OddballNo3/1u-VGA-driver/vga driver BOM.ods

Source:
Date:
Tool:
Generator:
Component Count: | 61
Collated Components:
Item | Qty | Reference(s) | Value | Footprint | PN
1 | 7 | C1, C4, C5, C8, C10, C12, C13 | 100n | Jfootprints:C_0805_2012Metric_Pad1.18x1.45mm_HandSolder
2 | 8 | C2, C3, C6, C7, C9, C11, C14, C15 | 10uF | Jfootprints:C_0805_2012Metric_Pad1.18x1.45mm_HandSolder
3 | 1 | D10 | BLUELED | Jfootprints:LED_D3.0mm
4 | 1 | D11 | GREENLED | Jfootprints:LED_D3.0mm
5 | 1 | D12 | REDLED | Jfootprints:LED_D3.0mm
6 | 1 | J1 | Conn_01x10 | Connector_IDC:IDC-Header_2x05_P2.54mm_Vertical
7 | 1 | J2 | RED OUT | Jfootprints:thonk switched jack | https://www.taydaelectronics.com/pj-3001f-3-5-mm-mono-phone-jack.html
8 | 1 | J3 | GREEN IN | Jfootprints:thonk switched jack | https://www.taydaelectronics.com/pj-3001f-3-5-mm-mono-phone-jack.html
9 | 1 | J4 | GREEN OUT | Jfootprints:thonk switched jack | https://www.taydaelectronics.com/pj-3001f-3-5-mm-mono-phone-jack.html
10 | 1 | J5 | BLUE IN | Jfootprints:thonk switched jack | https://www.taydaelectronics.com/pj-3001f-3-5-mm-mono-phone-jack.html
11 | 1 | J6 | BLUE OUT | Jfootprints:thonk switched jack | https://www.taydaelectronics.com/pj-3001f-3-5-mm-mono-phone-jack.html
12 | 2 | J7, J11 | Conn_01x03_Pin | Connector_PinHeader_2.54mm:PinHeader_1x03_P2.54mm_Vertical
13 | 1 | J8 | VGA | Jfootprints:VGA | https://www.digikey.com/en/products/detail/assmann-wsw-components/A-HDF-15-PP-Z/1241889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
14 | 1 | J9 | ISP | Connector_PinHeader_2.54mm:PinHeader_1x04_P2.54mm_Vertical
15 | 1 | J10 | RED IN | Jfootprints:thonk switched jack | https://www.taydaelectronics.com/pj-3001f-3-5-mm-mono-phone-jack.html
16 | 2 | J12, J13 | Conn_01x03_Socket | Jfootprints:PinHeader_1x03_P2.54mm_Vertical
17 | 3 | Q1, Q2, Q4 | MMBT3904 | Package_TO_SOT_THT:TO-92_HandSolder
18 | 2 | R1, R2 | 10r | Jfootprints:R_0805_2012Metric_Pad1.20x1.40mm_HandSolder
19 | 6 | R3, R4, R9, R10, R13, R14 | 100K | Jfootprints:R_0805_2012Metric_Pad1.20x1.40mm_HandSolder
20 | 3 | R5, R11, R15 | 1K | Jfootprints:R_0805_2012Metric_Pad1.20x1.40mm_HandSolder
21 | 2 | R6, R7 | 220R | Jfootprints:R_0805_2012Metric_Pad1.20x1.40mm_HandSolder
22 | 3 | R12, R16, R17 | 1M | Jfootprints:R_0805_2012Metric_Pad1.20x1.40mm_HandSolder
23 | 1 | R25 | BLED | Jfootprints:R_0805_2012Metric_Pad1.20x1.40mm_HandSolder
24 | 1 | R27 | GRLED | Jfootprints:R_0805_2012Metric_Pad1.20x1.40mm_HandSolder
25 | 1 | R28 | RLED | Jfootprints:R_0805_2012Metric_Pad1.20x1.40mm_HandSolder
26 | 1 | RV1 | 100KRED | Jfootprints:CLEAR POT | https://www.taydaelectronics.com/potentiometer-variable-resistors/rotary-potentiometer/linear/100k-ohm-linear-taper-potentiometer-d-shaft-pcb-9mm.html
27 | 1 | RV2 | 100KGREEN | Jfootprints:CLEAR POT | https://www.taydaelectronics.com/potentiometer-variable-resistors/rotary-potentiometer/linear/100k-ohm-linear-taper-potentiometer-d-shaft-pcb-9mm.html
28 | 1 | RV3 | 100KBLUE | Jfootprints:CLEAR POT | https://www.taydaelectronics.com/potentiometer-variable-resistors/rotary-potentiometer/linear/100k-ohm-linear-taper-potentiometer-d-shaft-pcb-9mm.html
29 | 1 | RV4 | 10k | Jfootprints:Borns Trimpot
30 | 1 | U1 | ATtiny85-20S | Jfootprints:SOIC-8
31 | 1 | U2 | L7805 | Package_TO_SOT_THT:TO-92_HandSolder
32 | 1 | U3 | TL074 | Jfootprints:SOIC-14_3.9x8.7mm_P1.27mm
33 | 1 | U6 | TL072 | Jfootprints:SOIC-8
